PikoPikoFactory/PikoKeyV1_1/image/IMG_5642.JPG

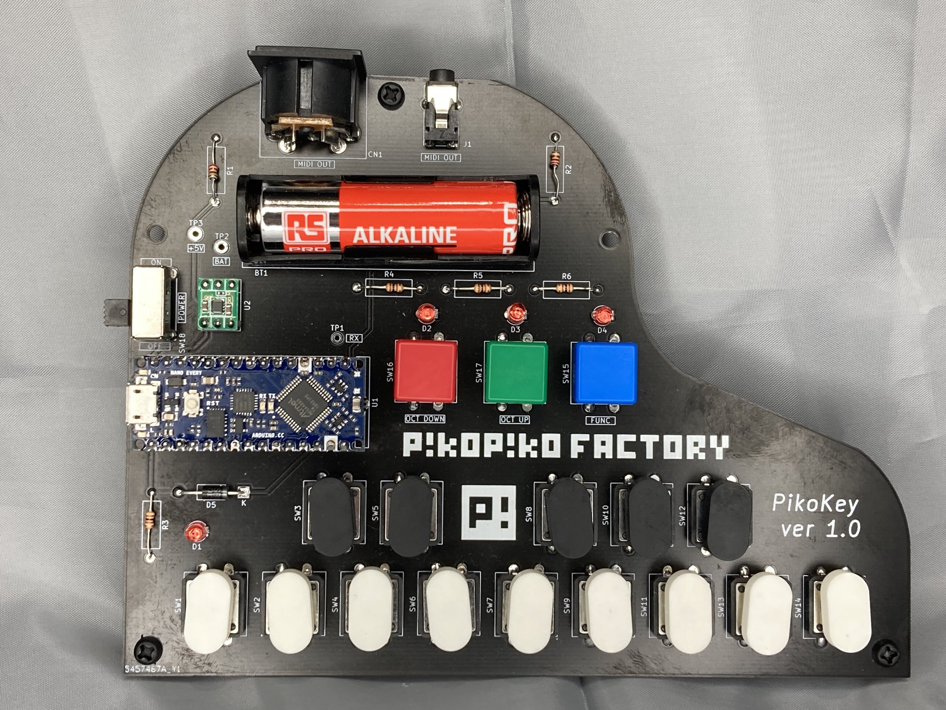
image/IMG_5642.JPG
