PikoPikoFactory/PikoKeyV1_1/image/IMG_5645.JPG

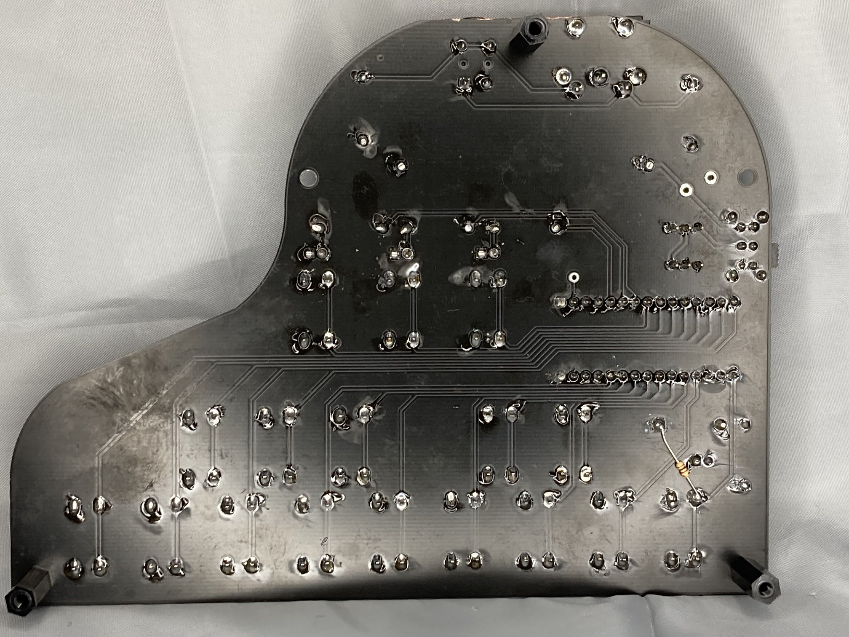
image/IMG_5645.JPG
