PikoPikoFactory/PikoKeyV1_1/image/IMG_5646.JPG

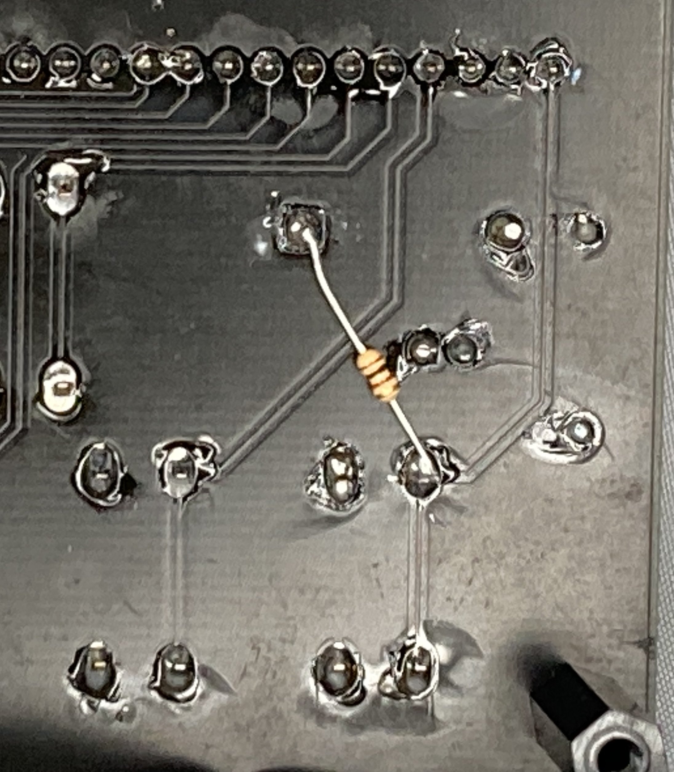
image/IMG_5646.JPG
