PikoPikoFactory/PikoKeyV1_1/Hardware/pikokeyV1_1_pattern.pdf

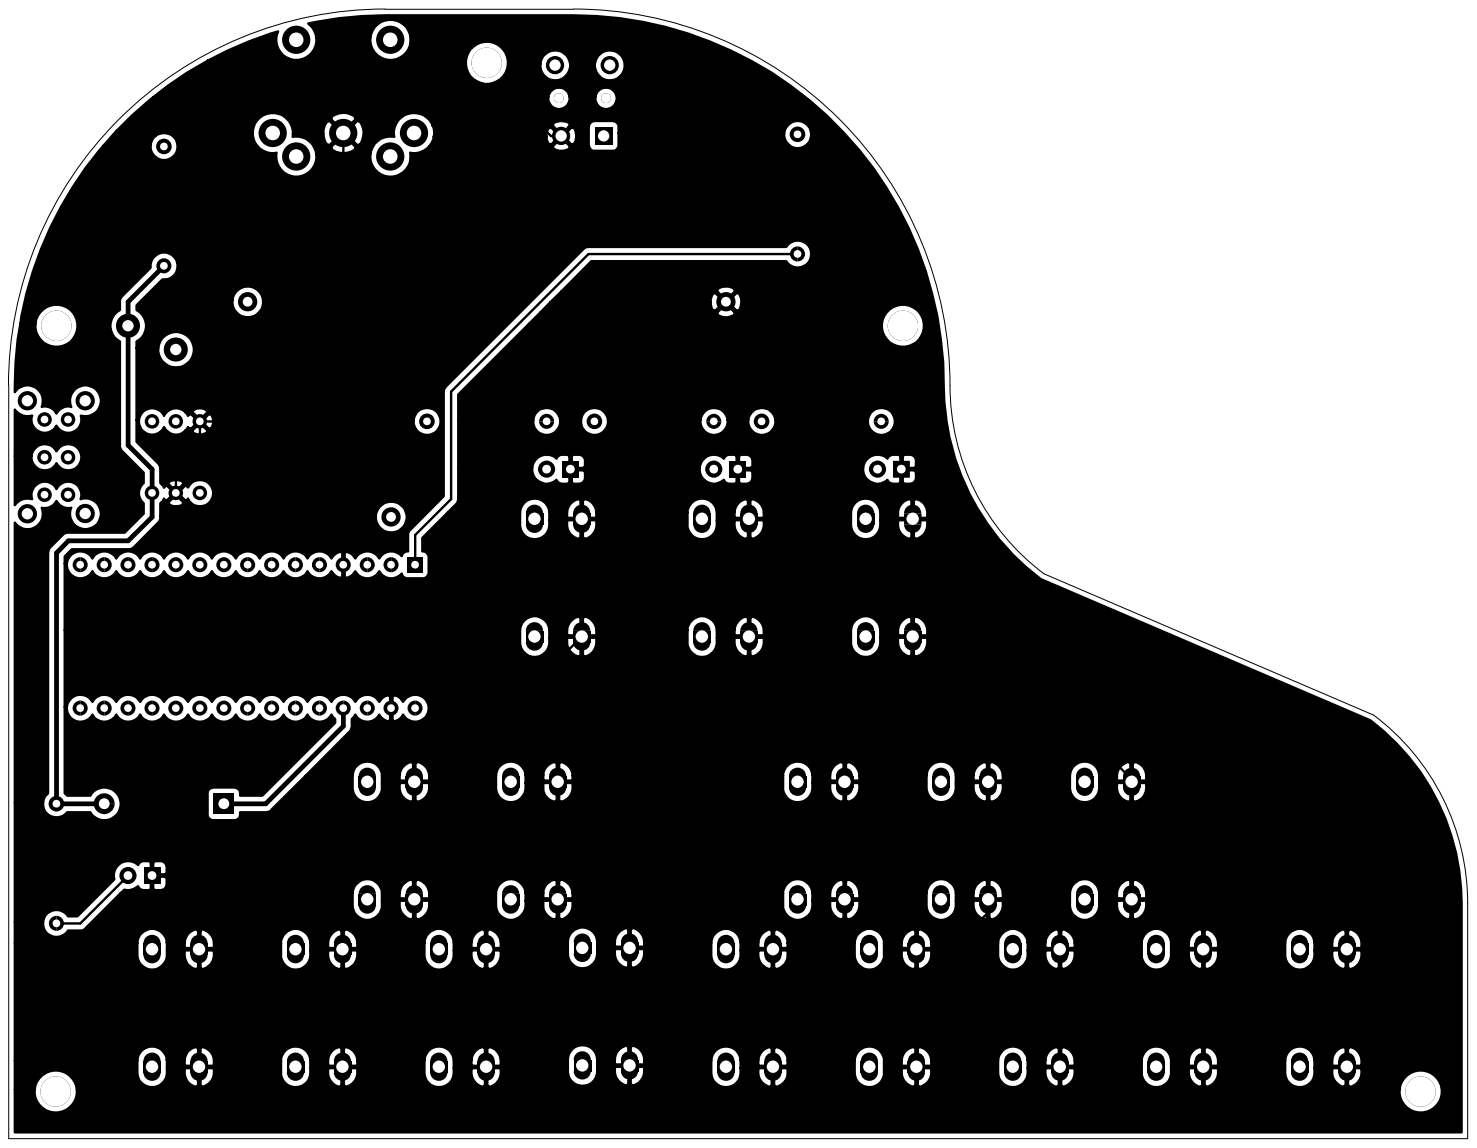
[picture p10: page 1]

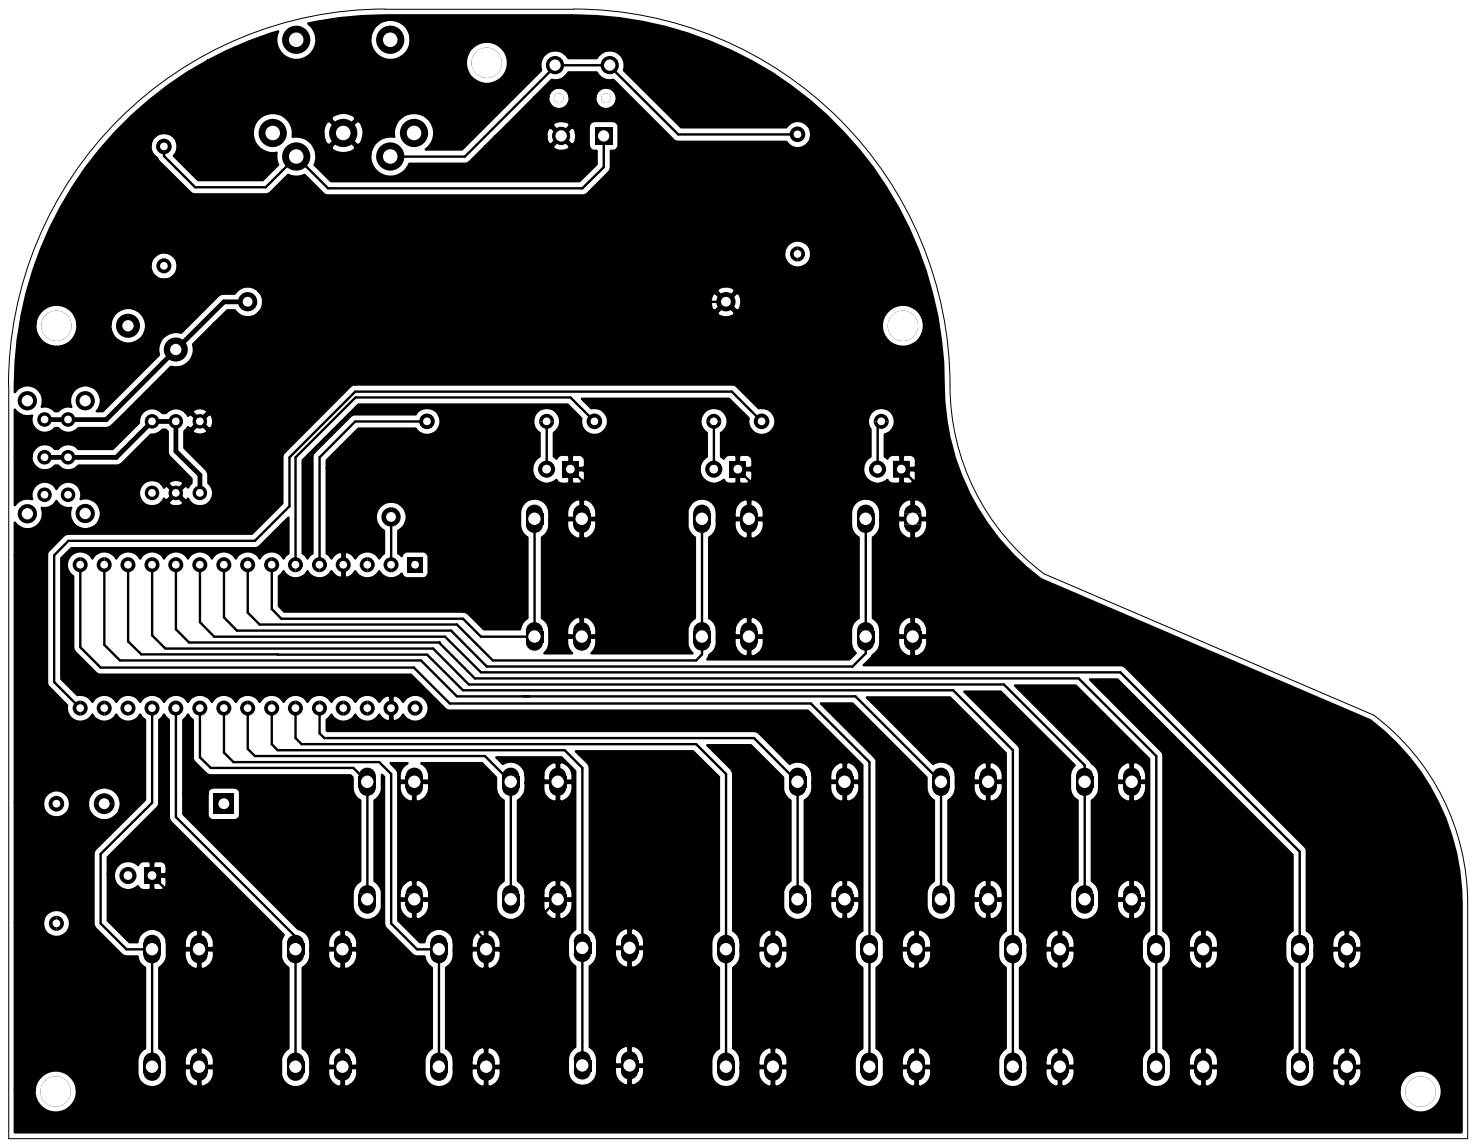
[picture p11: page 2]

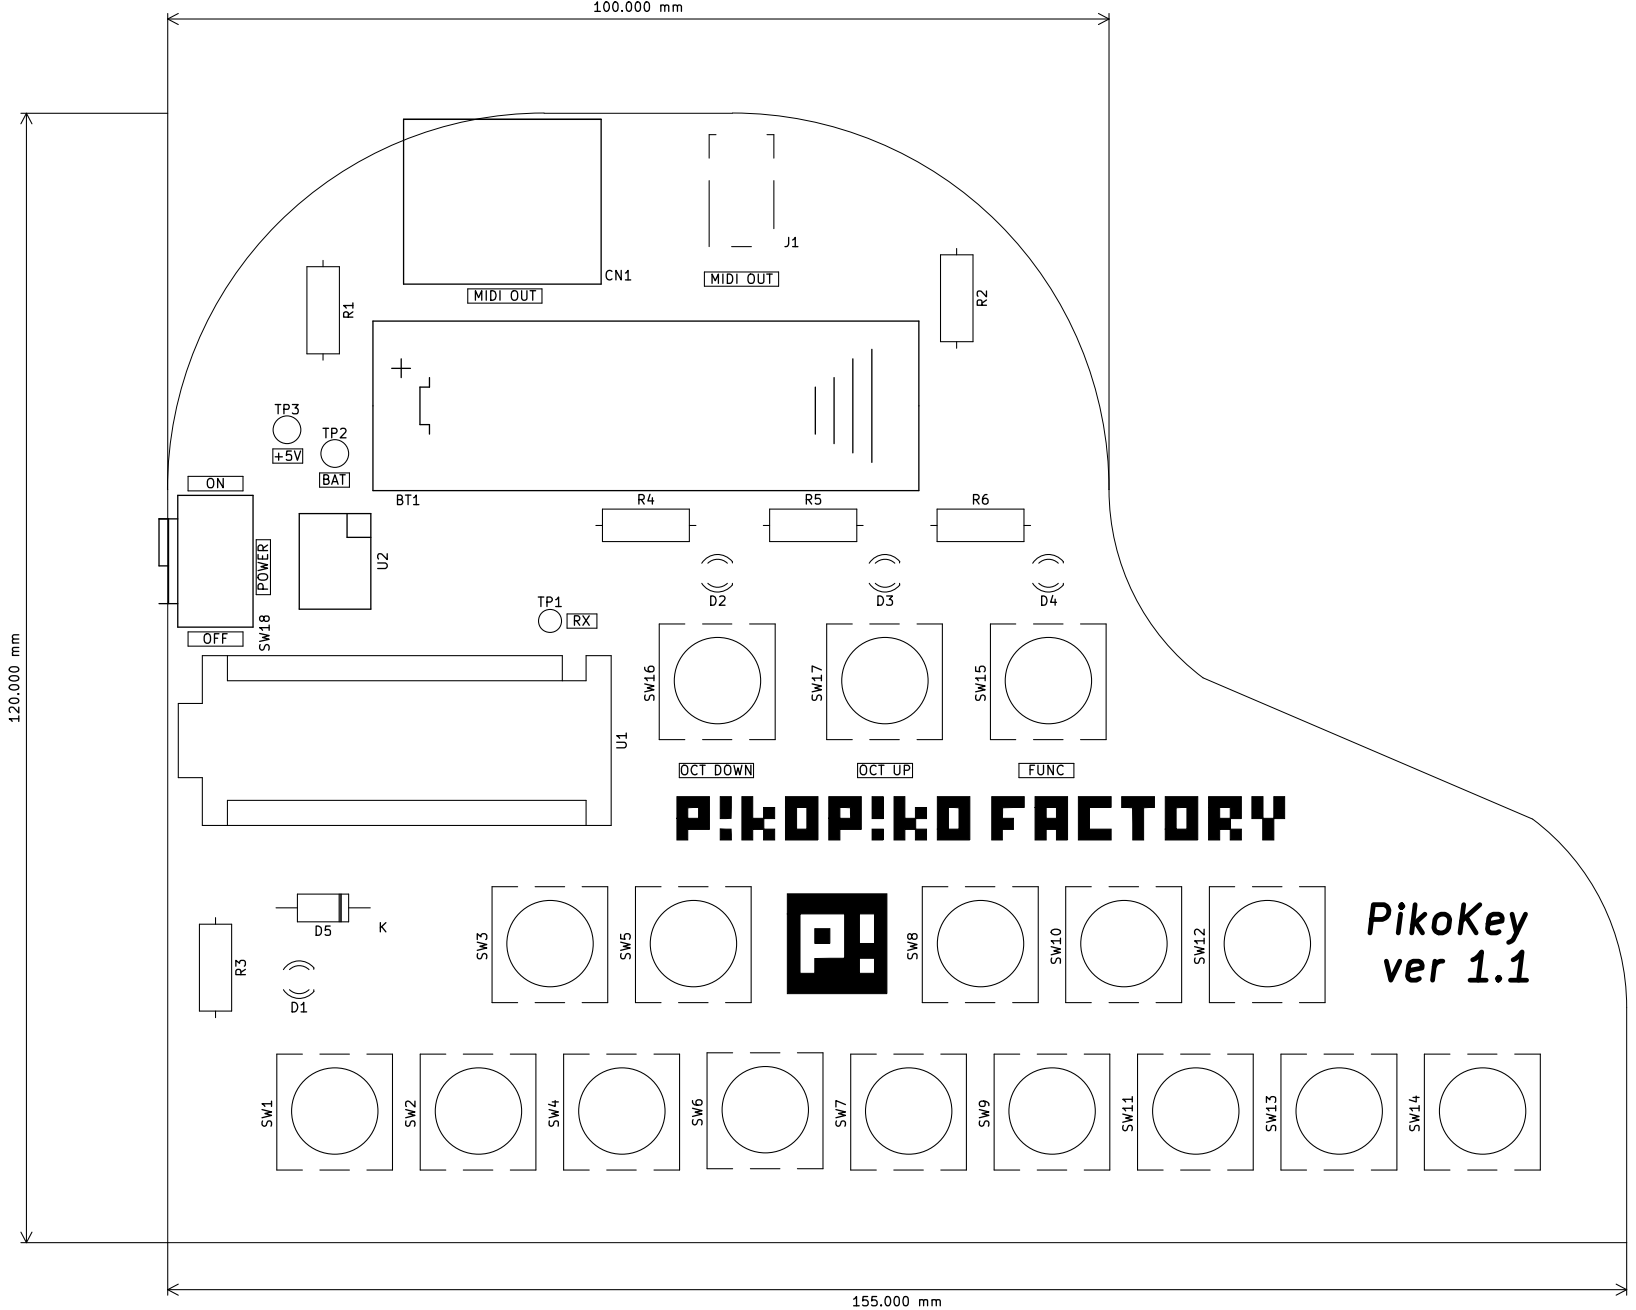
[picture p12: page 3]

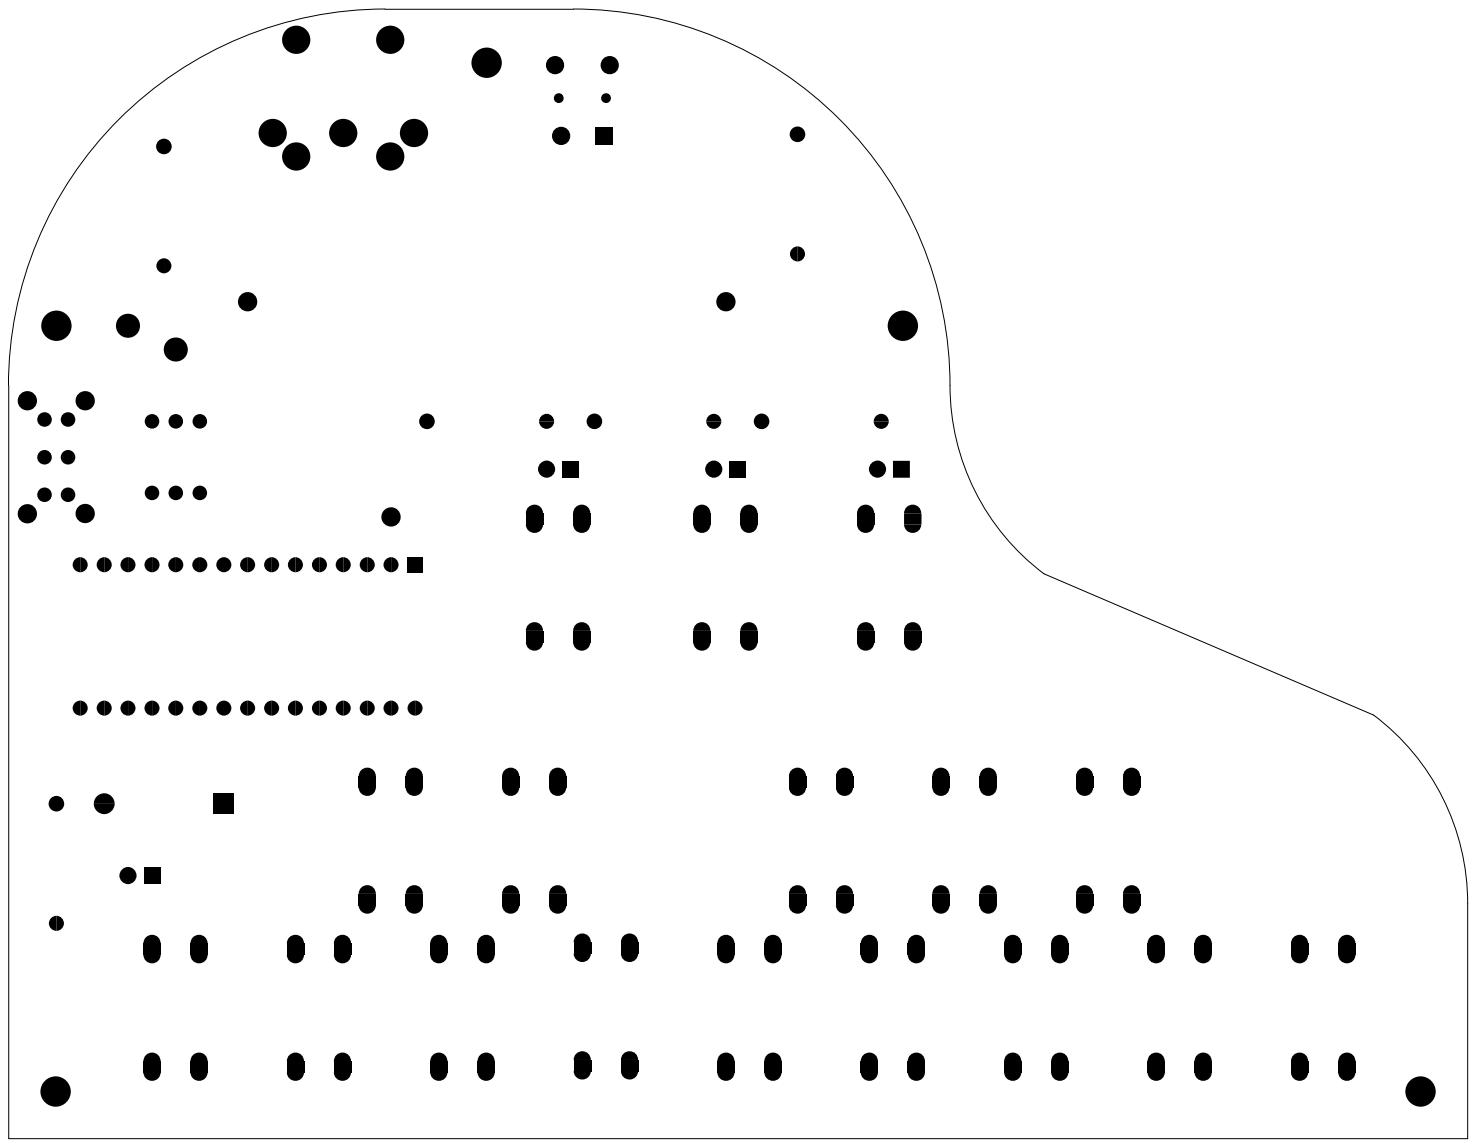
[picture p13: page 4]
