PikoPikoFactory/PikoKeyV1_1/Hardware/pikokeyV1_1_schematic.pdf

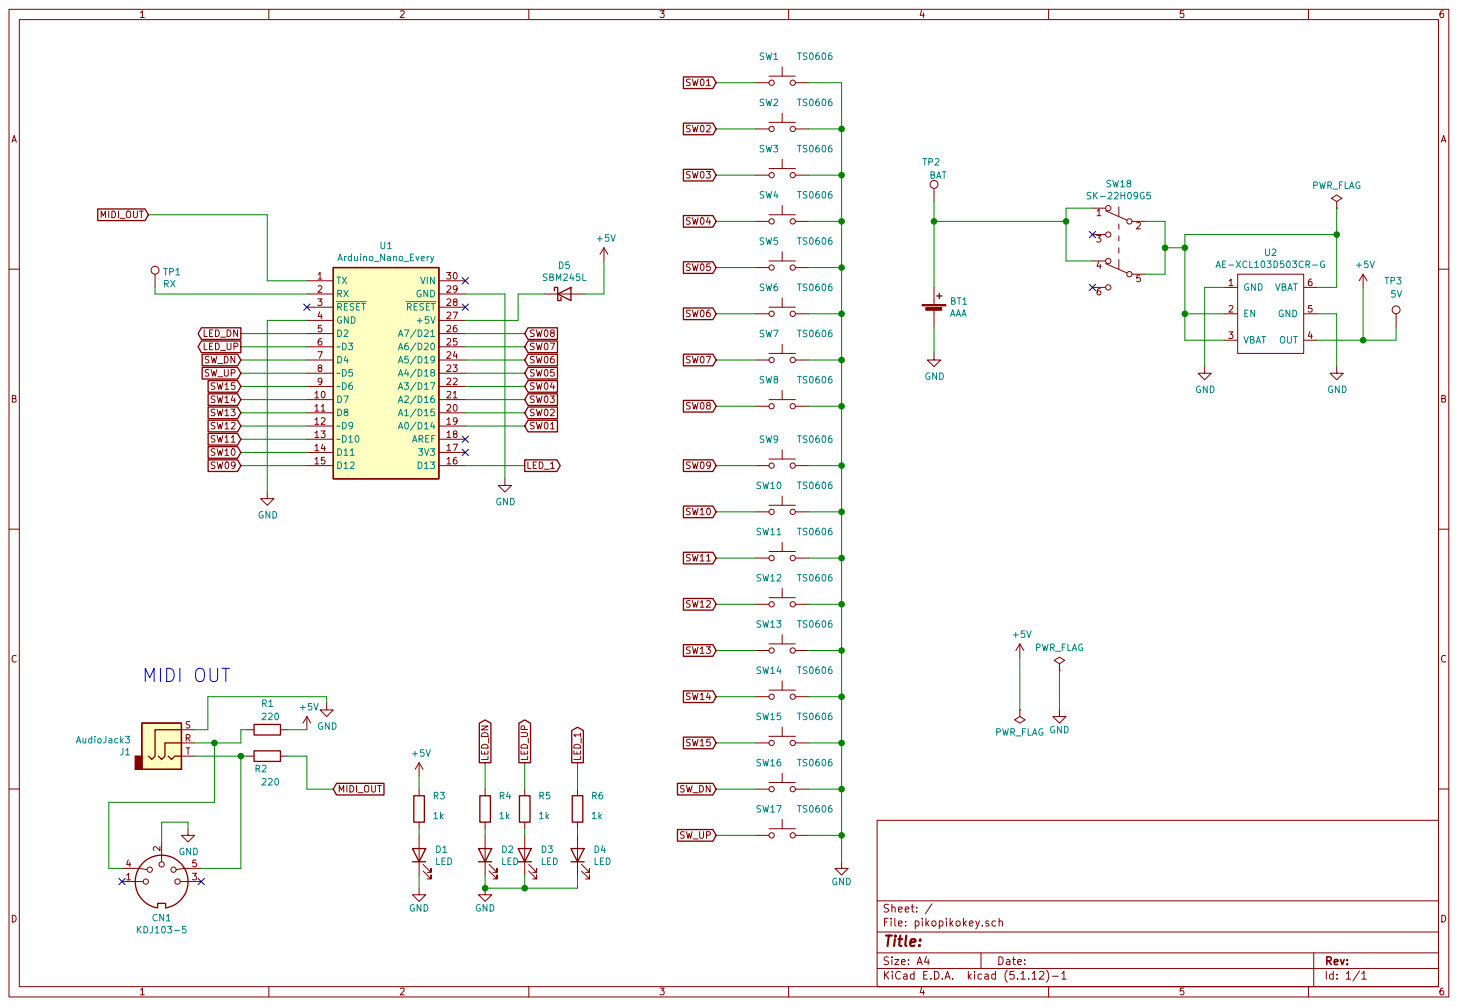
[picture p14: page 1]

File: pikopikokey.sch Sheet: / R6
